Poornimakulkarni26/Carrier-Loader-Unloader/Carrier_traySchematic.kicad_pcb

## KiCad design Carrier_traySchematic.kicad_pcb (2026-10-27)

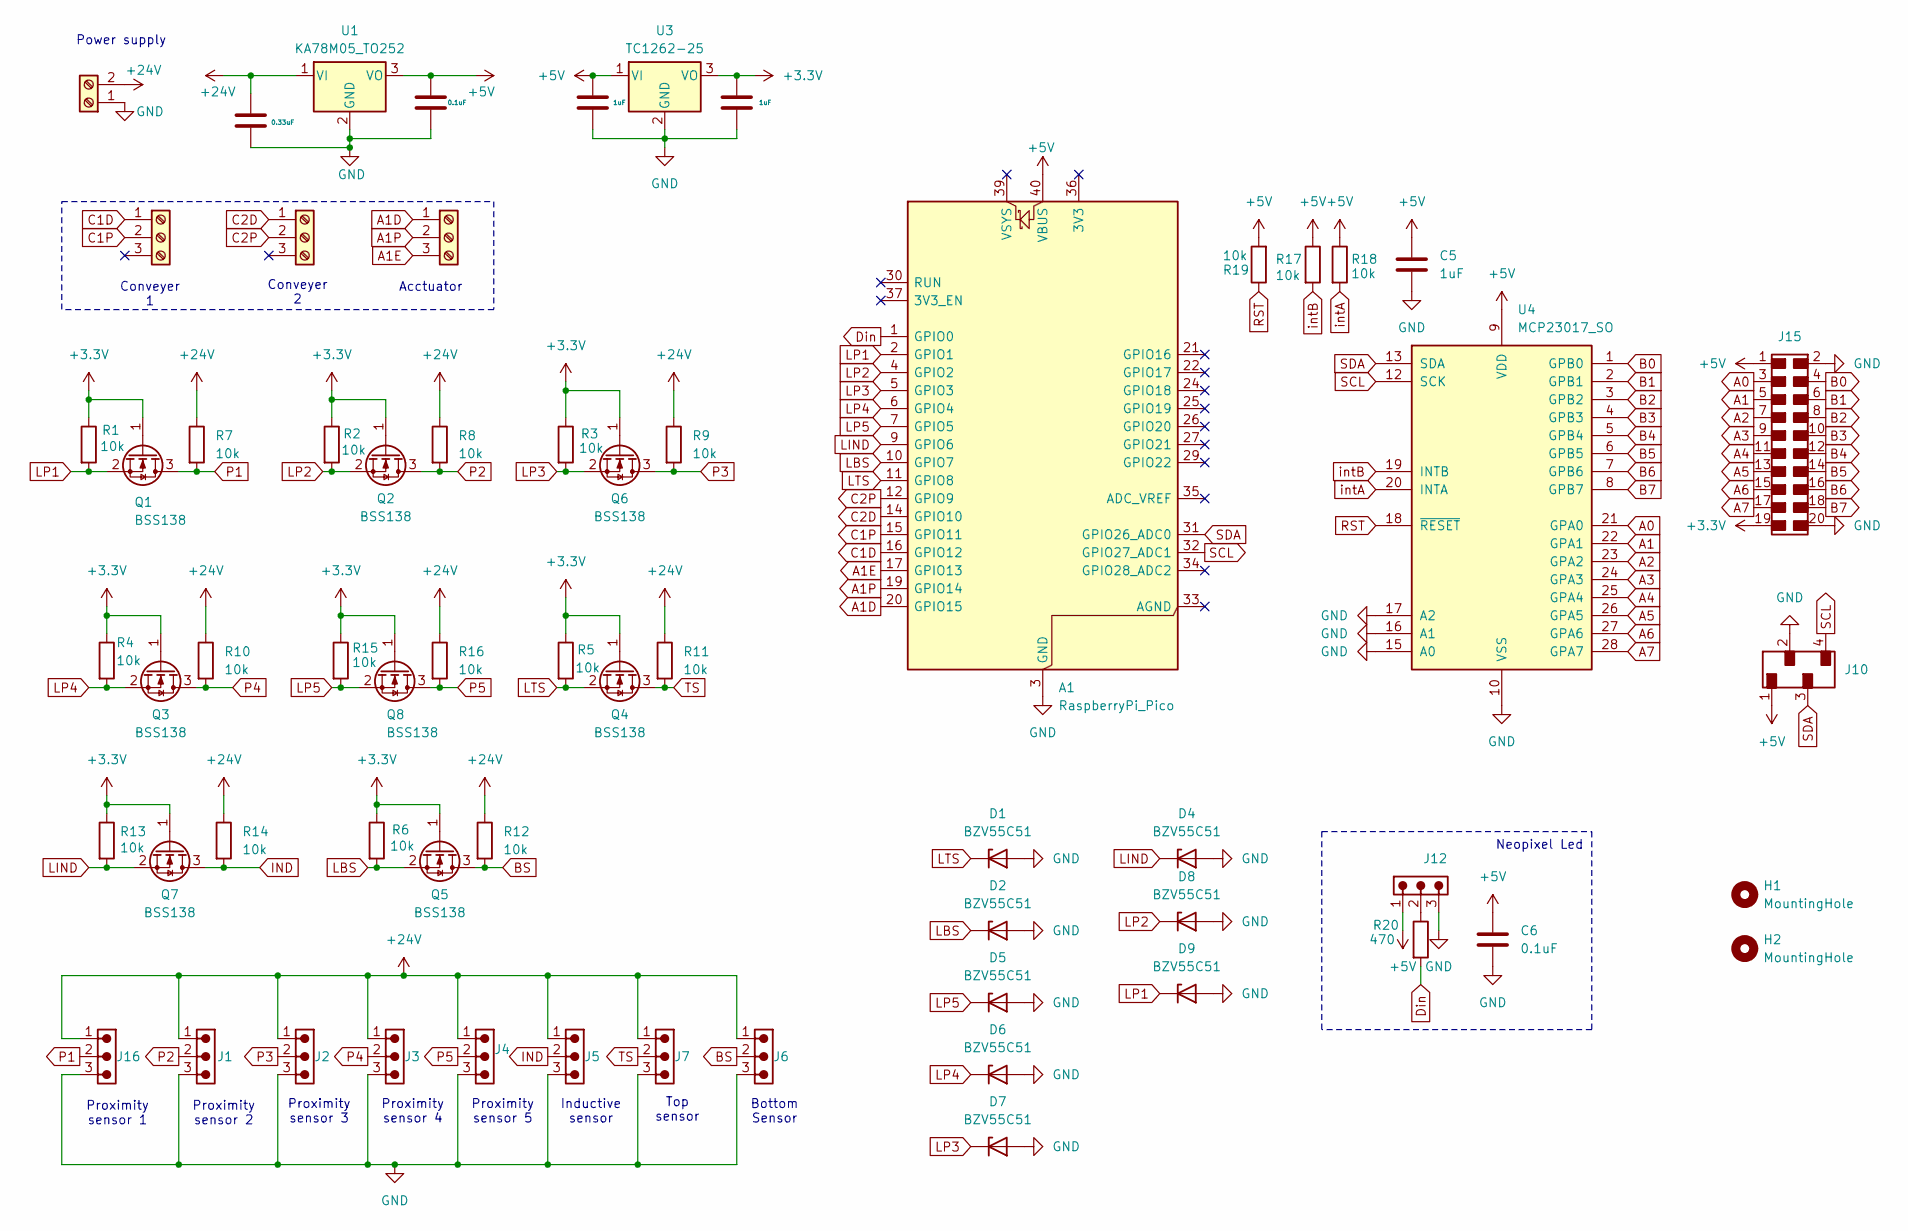
[picture p3: schematic Carrier_traySchematic.kicad_sch, Carrier Tray]

Parts:
A1: RaspberryPi_Pico; RaspberryPi_Pico_Common_Unspecified
C1: 0.33uF; C_0603_1608Metric_Pad1.08x0.95mm_HandSolder
C2, C6: 0.1uF; C_0603_1608Metric_Pad1.08x0.95mm_HandSolder
C3, C4, C5: 1uF; C_0603_1608Metric_Pad1.08x0.95mm_HandSolder
D1, D2, D4, D5, D6, D7, D8, D9: BZV55C51; D_MiniMELF
H1, H2: MountingHole; MountingHole_3.2mm_M3_DIN965_Pad
J1, J2, J3, J4, J5, J6, J7, J16: 68800311622; J_Wurth_WR-WTB_68800311622; Working Voltage (V (AC)) 250
J8, J9, J14: Screw_Terminal_01x03; TerminalBlock_Xinya_XY308-2.54-3P_1x03_P2.54mm_Horizontal
J10: 61000418221; J_Wurth_WR-PHD_61300411121
J11: Screw_Terminal_01x02; TerminalBlock_MetzConnect_Type011_RT05502HBLC_1x02_P5.00mm_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
J12: 61300311121; J_Wurth_WR-PHD_61300311121
J15: 621020245821; J_Wurth_WR-PHD_61302021821
Q1, Q2, Q3, Q4, Q5, Q6, Q7, Q8: BSS138; SOT-23
R1, R2, R3, R4, R5, R6, R7, R8, R9, R10, R11, R12, R13, R14, R15, R16, R17, R18, R19: 10k; R_0603_1608Metric_Pad0.98x0.95mm_HandSolder
R20: 470; R_0603_1608Metric_Pad0.98x0.95mm_HandSolder
U1: KA78M05_TO252; TO-252-2
U3: TC1262-25; SOT-223
U4: MCP23017_SO; SOIC-28W_7.5x17.9mm_P1.27mm

Connections:
+3.3V: C3.1, J15.19, Q1.1 (G), Q2.1 (G), Q3.1 (G), Q4.1 (G), Q5.1 (G), Q6.1 (G), Q7.1 (G), Q8.1 (G), R1.1, R2.1, R3.1, R4.1, R5.1, R6.1, R13.1, R15.1, U3.3 (VO)
+5V: A1.40 (VBUS), C2.1, C4.1, C5.1, C6.1, J10.1, J12.1, J15.1, R17.1, R18.1, R19.2, U1.3 (VO), U3.1 (VI), U4.9 (VDD)
+24V: C1.1, J1.1, J2.1, J3.1, J4.1, J5.1, J6.1, J7.1, J11.2, J16.1, R7.1, R8.1, R9.1, R10.1, R11.1, R12.1, R14.1, R16.1, U1.1 (VI)
A0: J15.3, U4.21 (GPA0)
A1: J15.5, U4.22 (GPA1)
A1D: A1.20 (GPIO15), J9.1
A1E: A1.17 (GPIO13), J9.3
A1P: A1.19 (GPIO14), J9.2
A2: J15.7, U4.23 (GPA2)
A3: J15.9, U4.24 (GPA3)
A4: J15.11, U4.25 (GPA4)
A5: J15.13, U4.26 (GPA5)
A6: J15.15, U4.27 (GPA6)
A7: J15.17, U4.28 (GPA7)
B0: J15.4, U4.1 (GPB0)
B1: J15.6, U4.2 (GPB1)
B2: J15.8, U4.3 (GPB2)
B3: J15.10, U4.4 (GPB3)
B4: J15.12, U4.5 (GPB4)
B5: J15.14, U4.6 (GPB5)
B6: J15.16, U4.7 (GPB6)
B7: J15.18, U4.8 (GPB7)
BS: J6.2, Q5.3 (D), R12.2
C1D: A1.16 (GPIO12), J14.1
C1P: A1.15 (GPIO11), J14.2
C2D: A1.14 (GPIO10), J8.1
C2P: A1.12 (GPIO9), J8.2
Din: A1.1 (GPIO0), R20.2
GND: A1.3 (GND), A1.8 (GND), A1.13 (GND), A1.18 (GND), A1.23 (GND), A1.28 (GND), A1.38 (GND), C1.2, C2.2, C3.2, C4.2, C5.2, C6.2, D1.2 (A), D2.2 (A), D4.2 (A), D5.2 (A), D6.2 (A), D7.2 (A), D8.2 (A), D9.2 (A), J1.3, J2.3, J3.3, J4.3, J5.3, J6.3, J7.3, J10.2, J11.1, J12.3, J15.2, J15.20, J16.3, U1.2 (GND), U3.2 (GND), U4.10 (VSS), U4.15 (A0), U4.16 (A1), U4.17 (A2)
IND: J5.2, Q7.3 (D), R14.2
LBS: A1.10 (GPIO7), D2.1 (K), Q5.2 (S), R6.2
LIND: A1.9 (GPIO6), D4.1 (K), Q7.2 (S), R13.2
LP1: A1.2 (GPIO1), D9.1 (K), Q1.2 (S), R1.2
LP2: A1.4 (GPIO2), D8.1 (K), Q2.2 (S), R2.2
LP3: A1.5 (GPIO3), D7.1 (K), Q6.2 (S), R3.2
LP4: A1.6 (GPIO4), D6.1 (K), Q3.2 (S), R4.2
LP5: A1.7 (GPIO5), D5.1 (K), Q8.2 (S), R15.2
LTS: A1.11 (GPIO8), D1.1 (K), Q4.2 (S), R5.2
unnamed: J12.2, R20.1
P1: J16.2, Q1.3 (D), R7.2
P2: J1.2, Q2.3 (D), R8.2
P3: J2.2, Q6.3 (D), R9.2
P4: J3.2, Q3.3 (D), R10.2
P5: J4.2, Q8.3 (D), R16.2
RST: R19.1, U4.18 (~RESET)
TS: J7.2, Q4.3 (D), R11.2
intA: R18.2, U4.20 (INTA)
intB: R17.2, U4.19 (INTB)

Notes on the sheet:
Proximity sensor 2
Bottom Sensor
Power supply
Proximity sensor 1
Proximity sensor 4
Top sensor
Conveyer 1
Acctuator
Conveyer 2
Proximity sensor 3
Neopixel Led
Proximity sensor 5
Inductive sensor

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
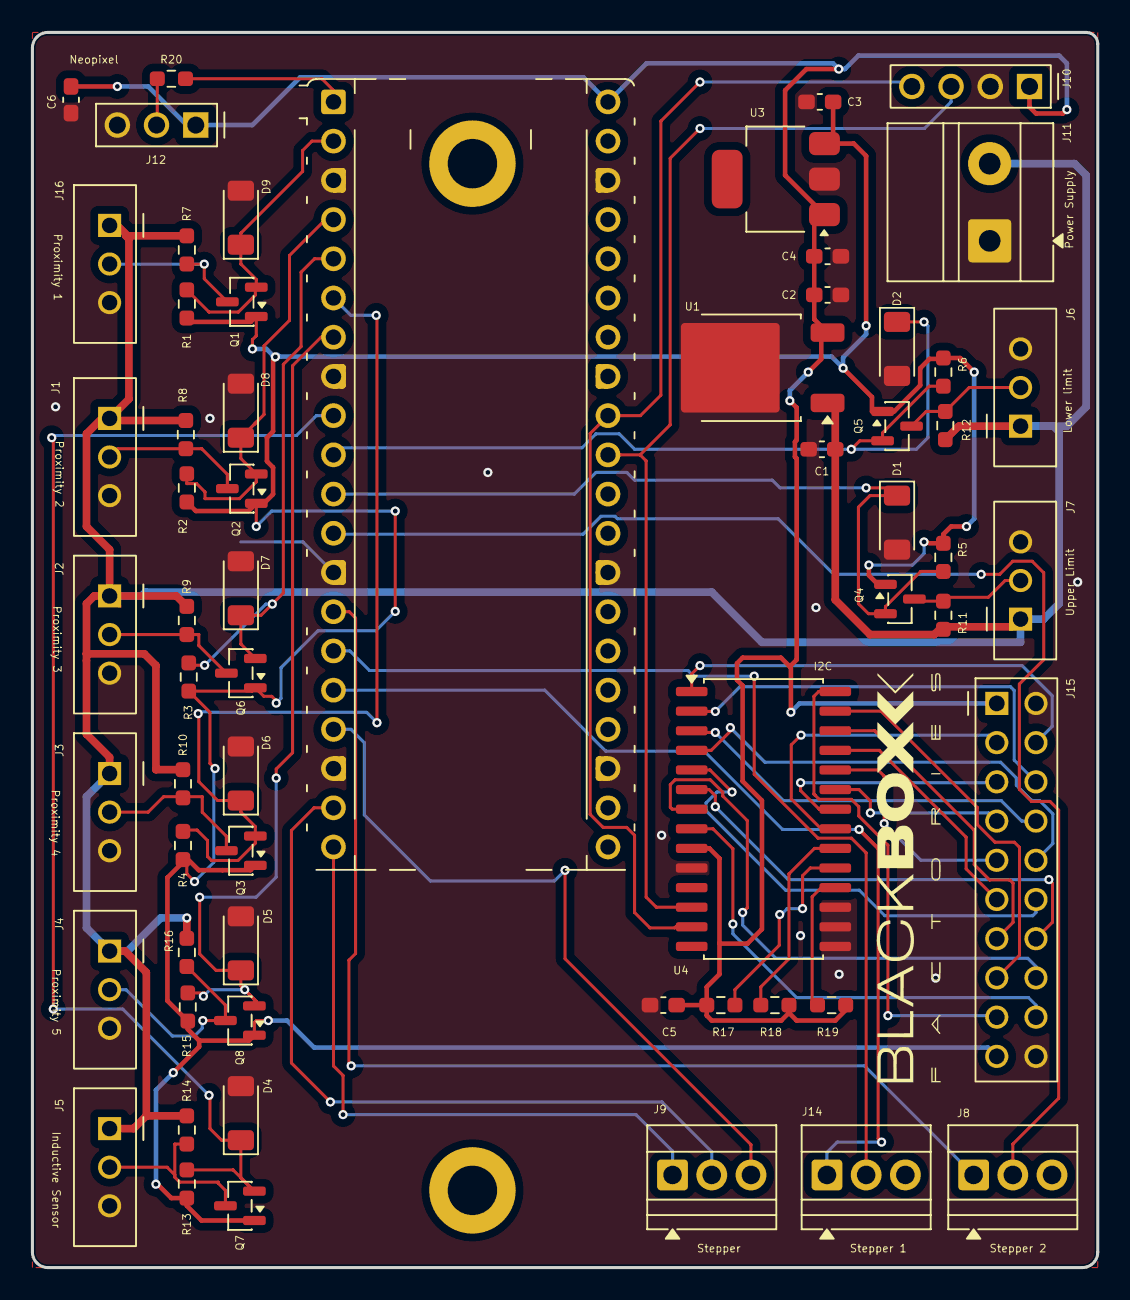
[picture p4: board Carrier_traySchematic.kicad_pcb from above]

Board: 2 copper layers, 69.0 x 80.0 mm, 63 parts (0 on the bottom side), 50 nets.
