Poornimakulkarni26/Carrier-Loader-Unloader/(notices)

Notices in the files:
README.md:
License: MIT
